cokoy-ng/person-tracking-camera-system/iot/images/conection-lcd.jpeg

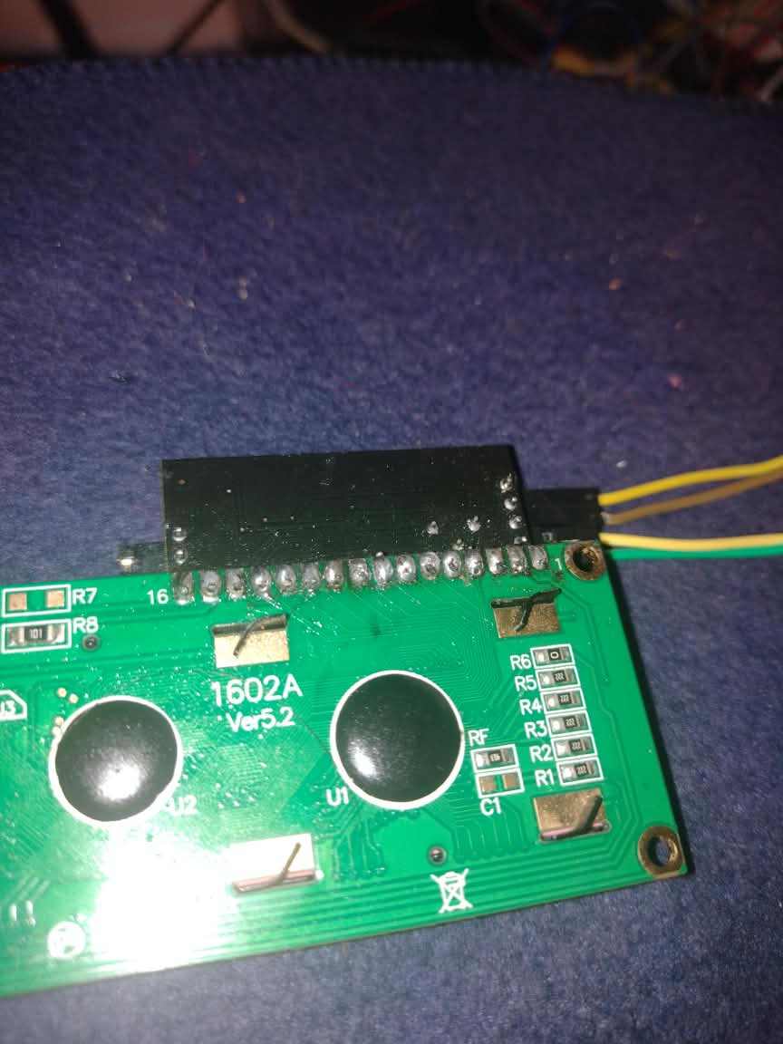
iot/images/conection-lcd.jpeg
