cokoy-ng/person-tracking-camera-system/iot/images/atras-lcd.jpeg

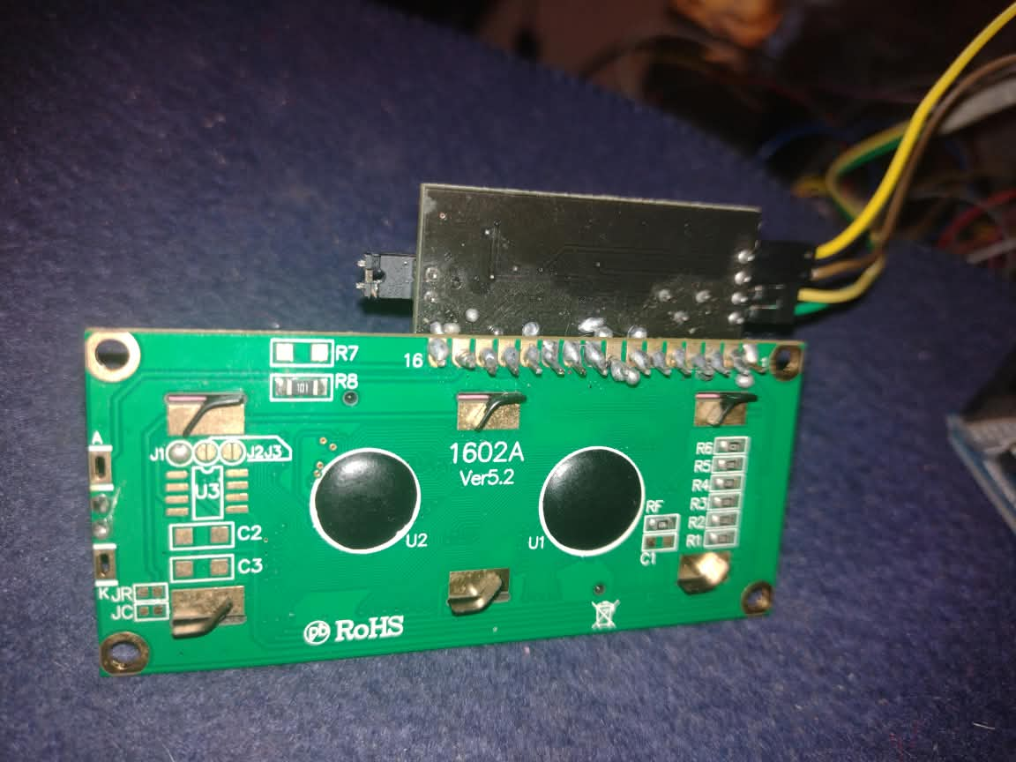
iot/images/atras-lcd.jpeg
