cokoy-ng/person-tracking-camera-system/iot/tracking/requirements-windows.txt

opencv-python>=4.12,<5
cv2-enumerate-cameras>=1.2,<2
pyserial==3.5
