cokoy-ng/person-tracking-camera-system/iot/firmware/brooder/PIN_REMAP_2026_11_04.md

# Adaptación de cableado — pendiente de puesta en marcha

Fuente preparada: BROODER_12_PIN_REMAP. Cargada y verificada en Uno COM6: 10932 bytes flash / 444 RAM.

| Pin | Función |
|---|---|
| A0 | Alarma HIGH |
| D5 | DHT11 (señal digital) |
| A1–A5 | Libres, sin lecturas ni escrituras del firmware |
| D2–D4 | Conectados según usuario, función pendiente; el firmware no los toca |
| D6 | Servo: prueba explícita Z; sin movimiento automático |
| D7 | Motobomba activa LOW; reutiliza canal humidifier, confirmar función de humedad |
| D8 | Ventilador activo LOW; reutiliza canal exhaust, confirmar sentido del aire |
| D9 | Calefacción HIGH |
| D10–D13 | ULN2003 IN1–IN4 |

La segunda salida de aire (intake) se retira: siempre apagada y mandos rechazados.
La puerta conserva DOOR_ENABLED=false y no altera automáticamente la referencia.
El arranque permanece en STOP. A libera STOP; S vuelve a detener las cargas.
El ciclo se selecciona explícitamente con una línea 1, 2, 3 o 4 por serie
115200. Esta selección provisional no persiste: al reiniciar no hay ciclo.
No se busca el sensor en D2–D4. Dos lecturas válidas en D5 confirman el ciclo.
Cambiar ciclo bloquea las salidas hasta confirmar las nuevas lecturas.

Pendiente para completar el funcionamiento automático: identificar D2–D4, confirmar
uso de bomba/ventilador, posiciones del servo y posición física de puerta.
No se ha validado movimiento, calor, bombeo ni sonido físicos.

Prueba real: D5 registra 26 °C / 46 % HR. Secuencia Z confirmada por ACK;
alarma, calefacción, bomba y ventilador activados individualmente con estados
CONTROL confirmados. Final: STOP, outputs00000, servo desconectado por software.
Falta confirmación visual de actuadores; puerta no movida. Evidencia:
`iot/diagnostics/brooder_validation_latest.json`.

Última corrección según ejemplo del usuario: Z usa write(180), espera10s,
espera3s, write(130), espera9s y detach. S cancela sin esperar. Se observaron
por serie ANGLE180, WAIT180, ANGLE130 y DONE. Bomba/ventilador confirmados
por CONTROL con polaridadLOW. Lectura26–27°C/45%HR; calefacción bloqueada
a27°C por límite del ciclo4. El usuario todavía debe confirmar movimiento físico.

## Dashboard integrado

El usuario confirmó movimiento físico del servo tras usar write180/130.
Firmware con telemetría de dashboard cargado en COM6:11264flash/446RAM.
`report()` informa FIRMWARE, CYCLE_REQUEST y SERVO (etapa, última orden angular,
segundos restantes), además de estados previos. Consultar `?` no mueve nada.

Dashboard http://localhost:5173, backend http://localhost:8000.
POST /api/device admite action servo_cycle, stop, resume o cycle (cycle1..4).
Se registra cada solicitud antes de enviarla. El ciclo del servo se envía una
sola vez, sin reintentar automáticamente un movimiento sin ACK. STOP cancela
el servo y pausa cargas, pero conserva el modo de alarma.
Reanudar conserva los modos de cada salida; usar Automático individualmente
para liberar un apagado manual. Inicio del dashboard no reanuda control.

El panel muestra los nuevos pines, selector de ciclo y botón para un ciclo
único del servo, con estado/tiempo restante reportado por Arduino. A1-A5 no
son salidas de aire. La puerta permanece deshabilitada hasta confirmar posición.

## Corrección manual y puerta — versión vigente BROODER_13_MANUAL_DOOR

Cargada/verificada COM6:12440flash/495RAM. D7, D8 y D9 activosLOW.
D9 se cambió de HIGH a LOW siguiendo el tipo de relés del montaje; su polaridad
física está pendiente de confirmación. Se observó sensor38°C/28%HR con
calefacción lógicamenteOFF antes del cambio, lo cual no prueba por sí solo
la causa térmica. No se probó encendido físico de calefacción a esa temperatura.

Encender manualmente una salida permite esa salida durante la pausa del
automático. Las demás siguen pausadas. STOP cancela esa autorización y detiene
motores. Temporizador vencido vuelveauto y respeta pausa. Sensor/ciclo inválido,
máximoT para calefacción, máximoHR para bomba y mínimoT para aire siguen cortando.
BLOCKcodes comunica los motivos concretos al backend y a la pantalla.

Puerta habilitada SOLO en manual (DOOR_AUTO_ENABLED=false): B abrir, D cerrar,
X detener; O/C registrar extremo abierto/cerrado. No se mueve sin referencia.
La UI exige confirmar físicamente el extremo antes de O/C. No se ejecutó
referencia ni movimiento real durante validación. Abrir/cerrar no se reintenta
sin ACK. STOP impide reanudación del motor sin nueva orden manual. El motor puede
operarse con clima en pausa y no depende del DHT11. Cuenta pasos, sin finales de
carrera; recorrido12vueltas. EEPROM marca posición inválida durante movimiento.

API /api/device suma door_open, door_close, door_stop, door_reference_open y
door_reference_closed. Referencias requieren confirmed_position=true. Vista
muestra botones y exige referencia; C++ prueba referencia/marcha/parada/limites.

Validación real desde Chrome: D7 y D8 modeon/ontrue con stoppedtrue, apagado
posterior confirmado. Puerta sin referencia rechazada409 sin moverla. UIescritorio
ymóvil sin desborde ni erroresJS. 39testsbackendOK, frontendbuild/lintOK.

## Versión vigente: BROODER_14_PHYSICAL_CYCLES

Corrección solicitada por usuario: la señal del único DHT11 se mueve físicamente
entre D2–D5 para seleccionar el rango. No fijar sensor en D5 para todos los ciclos.

| Señal del DHT11 | Ciclo | Días | Temperatura | Humedad |
|---|---|---|---|---|
| D2 | 1 | 1–3 | 33–34°C | 60–70% |
| D3 | 2 | 4–7 | 30–32°C | 50–65% |
| D4 | 3 | 8–14 | 27–29°C | 50–60% |
| D5 | 4 | 15–21 | 24–27°C | 50–60% |

Se escanean los cuatro pines cada2.5s, se requieren dos muestras válidas
consecutivas y un único sensor detectado. Sin sensor o con varios detectados,
se bloquea el clima. No se aceptan selecciones de ciclo por API/botones ni por
órdenes1..4. La app muestra el pin real en cada ciclo. Los pines del servo,
relés y puerta conservan la distribución de versión13. No hay sensor en A1.
Arduino Uno compile/uploadverify:12508flash/500RAM. Backend41testsOK, C++
selectores/firmwareOK, frontendbuild/lintOK.

Comprobación real tras carga14: los cuatro pines reportan diagnóstico1
(sin respuesta),mask0,ciclo0. No se confirmó lectura física enD2. La app
muestra ahora diagnósticos porpin. Verificar DATA enD2digital(noA2),5V/GND;
no declarar ciclo1detectado hasta recibir lectura.

## Vigente: BROODER_15_AUTO_CYCLES — adaptación automática

Arranca en automático, condicionado a dos muestras válidas del único sensor en
D2/D3/D4/D5. Si se desconecta o hay conflicto, apaga las salidas de clima.
Al confirmar un pin distinto del último ciclo válido, calefacción/bomba/ventilador
vuelven a modoauto; no se arrastran modos manuales del ciclo anterior.
Una desconexión temporal y regreso al mismo pin no borra un modo manual elegido.
STOP explícito se mantiene aunque cambie el cable; Activar automático (A) libera
STOP y devuelve esas tres salidas a automático.

Calefacción ON<=máximo-1, OFF>=máximo. En temperatura<=mínimo fuerza encendido
inmediato; dentro del rango conserva espera60s para evitar conmutaciones rápidas.
Bomba ON<=centroHR-2, OFF>=centroHR y corte inmediato>=máximoHR. Ventilador ON
por T>=máximo o HR>=centro+2, OFF al volver a bordes; bloqueado por T<=mínimo
para no enfriar más. Permanencia15s en aire, con límites prioritarios.
La puerta y servo siguen siendo manuales. No es posible regular sin lectura real.
Alarma por puerta sin referencia ya no se añade al clima cuando puerta solo manual.

Pruebas: C++ cuatro perfiles, cambios 1→2→3→4→1 con ambiente constante,
recuperación frío/HRbaja, STOP persistente, restauración de modos y sensor ausente.
43testsbackendOK y frontendbuild/lintOK. La validación física sigue separada de
las pruebas de lógica; confirmar conexión de sensor y polaridad real D9.

Carga15verificada:12690flash/500RAM. Verificación real: sensorD4,ciclo3,
31°C39%HR; Arduino modoauto,calefacciónOFF,bombaON,ventiladorON,stoppedfalse.
Dashboard realWindows escritorio/móvilOK. Confirmación física de bomba/aire
y polaridadD9LOW sigue pendiente. Se deja control automático activo por petición.

## Vigente: BROODER_16_MANUAL_PUMP — bomba exclusivamente manual

Usuario aclaró que D7 no humidifica automáticamente: solo debe encender por
orden manual. Se retiró demanda automática por HR del controlador, no solo del
panel. D7 arrancaOFF y no cambia por pin/ciclo ni por Activarautomático. Solo
Encender/Apagar, con duración elegida o hastaApagar. Al terminar temporizador
se apaga; STOP también la apaga. La orden manual no depende de lectura del DHT11
ni de límitesHR; calefacción y ventilador conservan sensor/límites y automático.
API y protocolo rechazan modoauto de bomba. UI no muestra botónAutomático ni
umbrales de humedad paraD7. HR se sigue vigilando y ventilación por excesoHR se
conserva, pero ninguna salida añade humedad automáticamente.

CargaCOM6verify:12776flash/492RAM. 45testsbackendOK, C++incluyeHRbaja en4ciclos,
cambiodepin/activaciónauto sin encenderbomba y temporizador/STOP/OFF. ChromeWindows
real:D4ciclo3,31°C37%HR,bomba modeoff/onfalse/manual_onlytrue; botonesEncender/Apagar,
solicitudauto rechazada409 sin actuar. UIescritorio/móvilOK. Bomba quedóapagada.
