cokoy-ng/person-tracking-camera-system/ai/comp_vision/emotion-detector/face_detector/z_links.txt

deploy.prototxt: https://github.com/opencv/opencv/blob/master/samples/dnn/face_detector/deploy.prototxt
res10_300x300_ssd_iter_140000.caffemodel: https://github.com/opencv/opencv_3rdparty/raw/dnn_samples_face_detector_20170830/res10_300x300_ssd_iter_140000.caffemodel
