cokoy-ng/person-tracking-camera-system/docs/visual_circuito.png

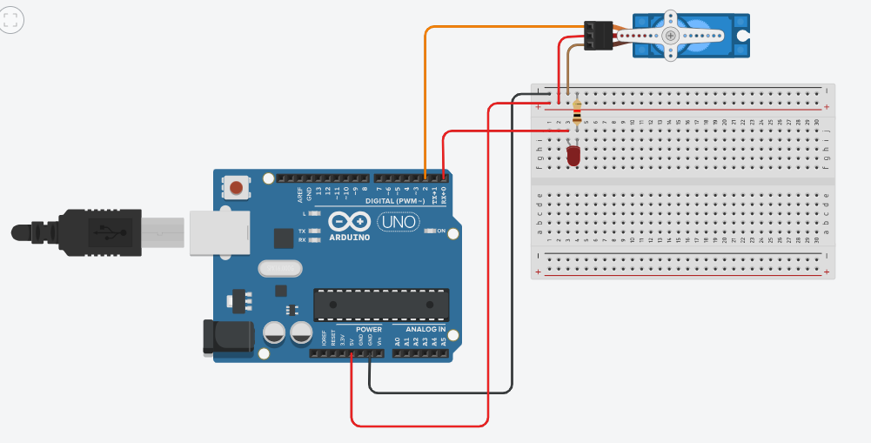
docs/visual_circuito.png
