cokoy-ng/person-tracking-camera-system/iot/images/delante-lcd.jpeg

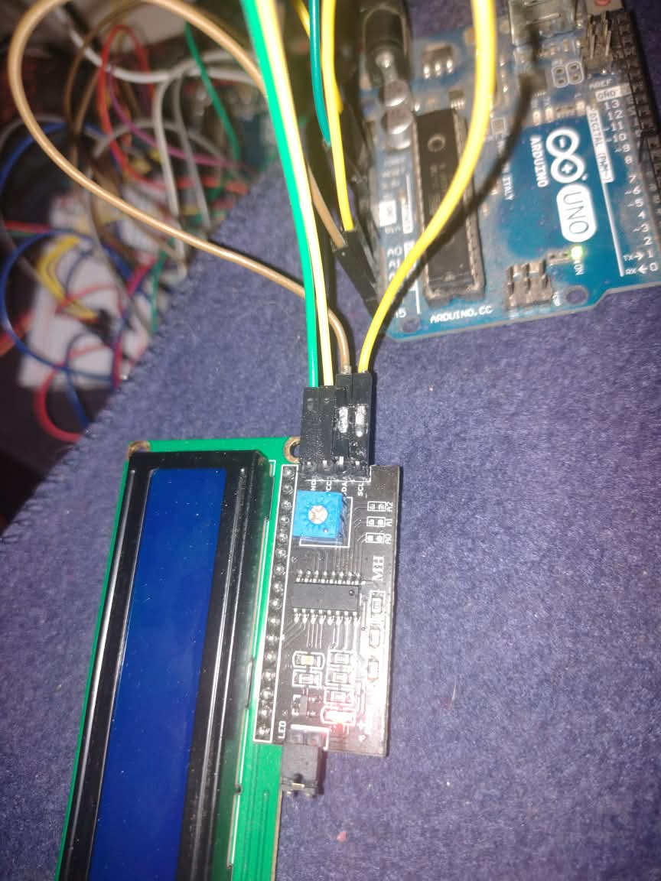
iot/images/delante-lcd.jpeg
