cokoy-ng/person-tracking-camera-system/iot/images/update-lsd.jpeg

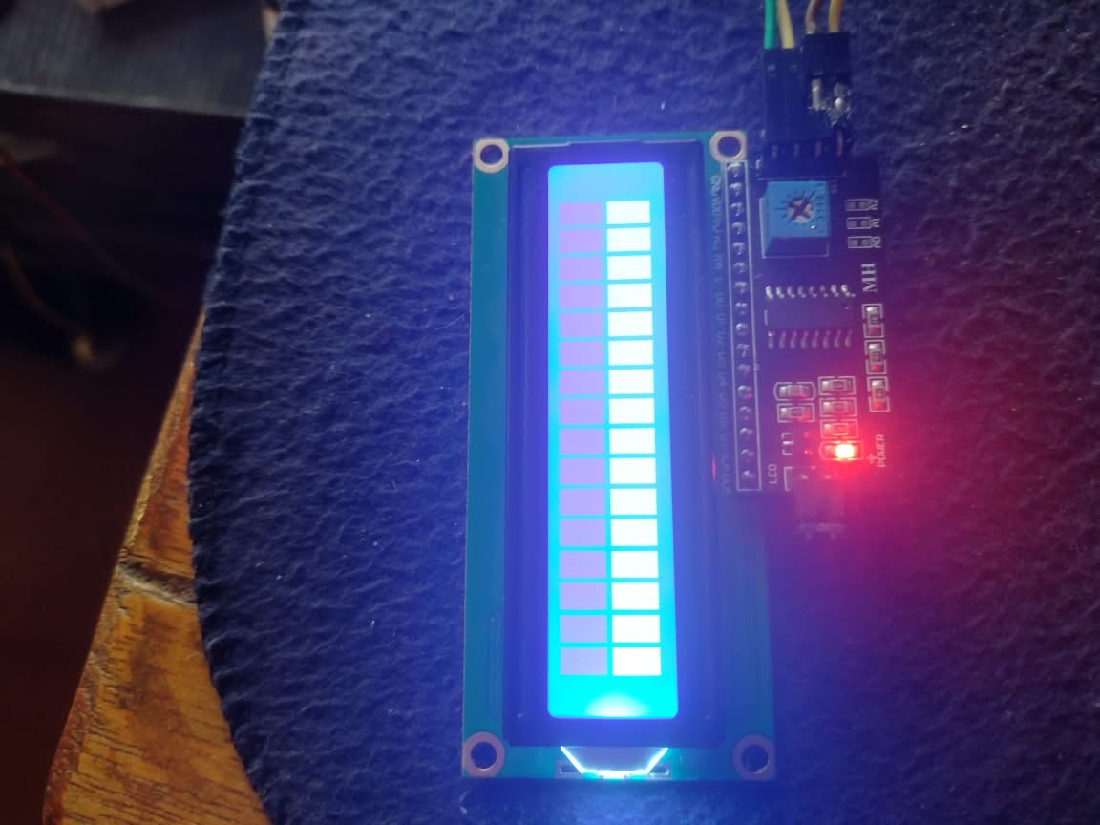
iot/images/update-lsd.jpeg
