cokoy-ng/person-tracking-camera-system/docs/Circuito-Conexión-Servo-motor-sg90.pdf

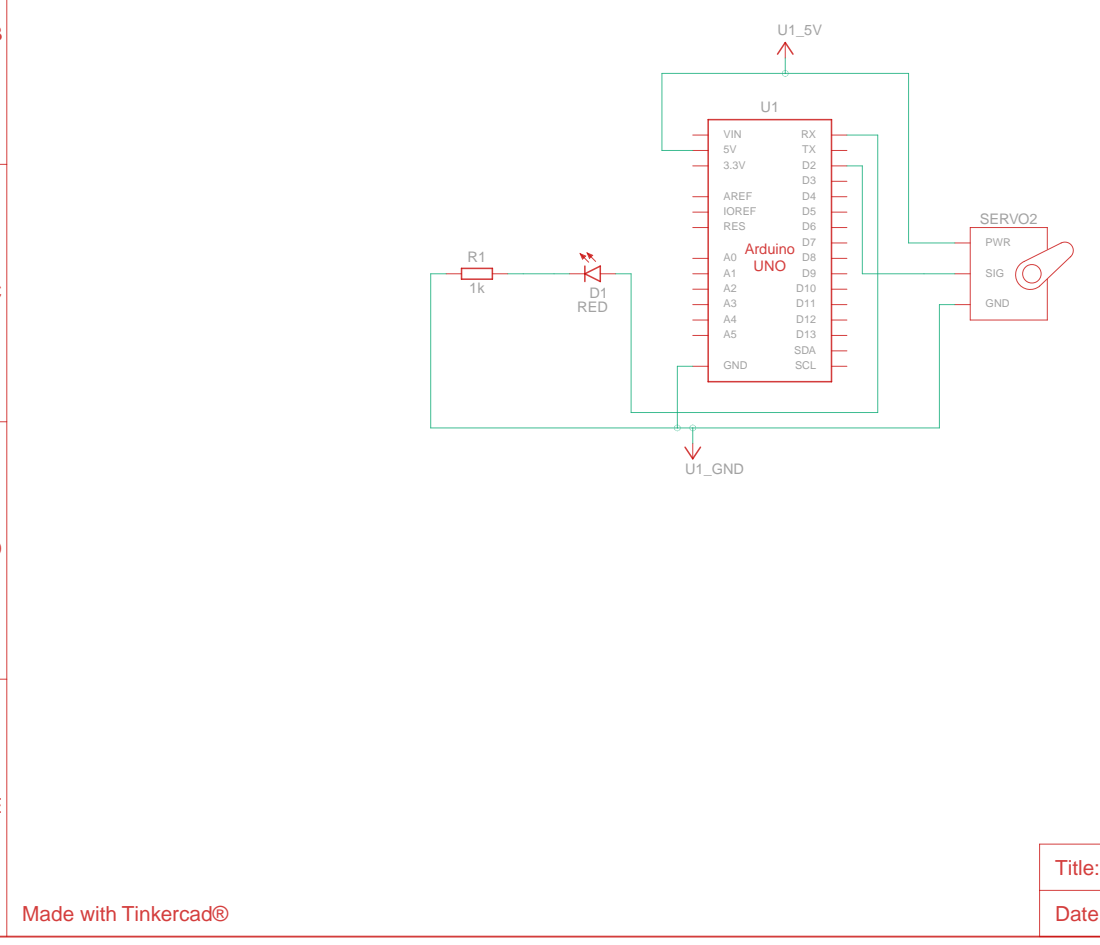
[picture p6: page 1]

Title: Copy of Circuito Conexión Servo motor sg90
