cokoy-ng/person-tracking-camera-system/(commit log)

2026-09-13 Add camera, AI tectection and aduino servo control
    [bom.csv]
2026-09-22 S verifico funcionalidad de conxion de 5to pin analogico de sentor de temperatura y humedad
2026-09-23 update estructuracion de carpetas
    [bom.csv]
2026-09-23 Actualización de contexto
2026-09-23 Actualizacion de contexto y ejecucion de todo el proeycto
2026-10-27 Se agreso sensores de un sitema de crianza de pollos
2026-11-06 Agrega lanzador de servicios con estado, parada y verificación de Arduino
2026-11-06 Integra visión de pollitos con cámara, seguimiento y zonas en el dashboard
